pa-pa/HB-Sec-RHS-3/files/RHS_3.png

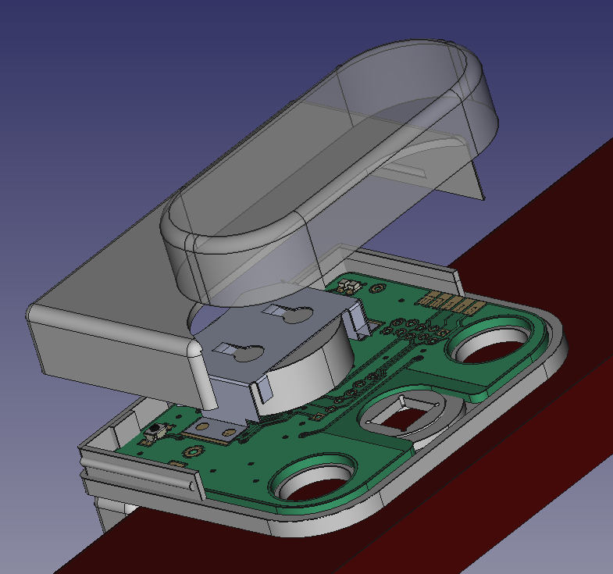
files/RHS_3.png
