pa-pa/HB-Sec-RHS-3/files/RHS_3_Front.png

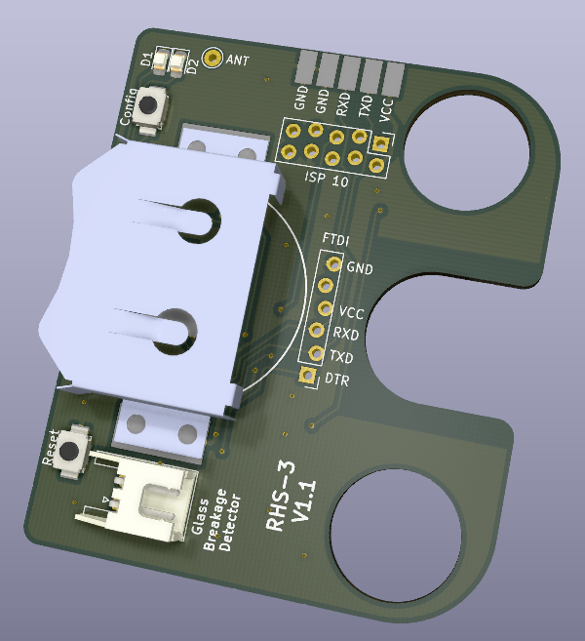
files/RHS_3_Front.png
