pa-pa/HB-Sec-RHS-3/files/RHS_3_small.png

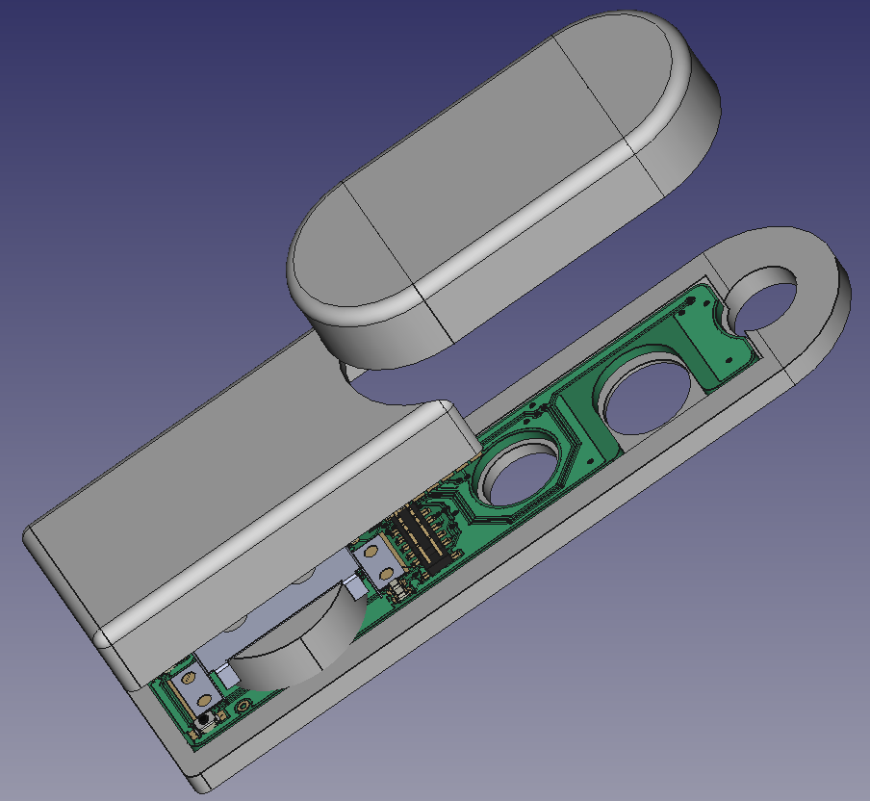
files/RHS_3_small.png
