pa-pa/HB-Sec-RHS-3/FreeCad/RHS_3_small.FCStd

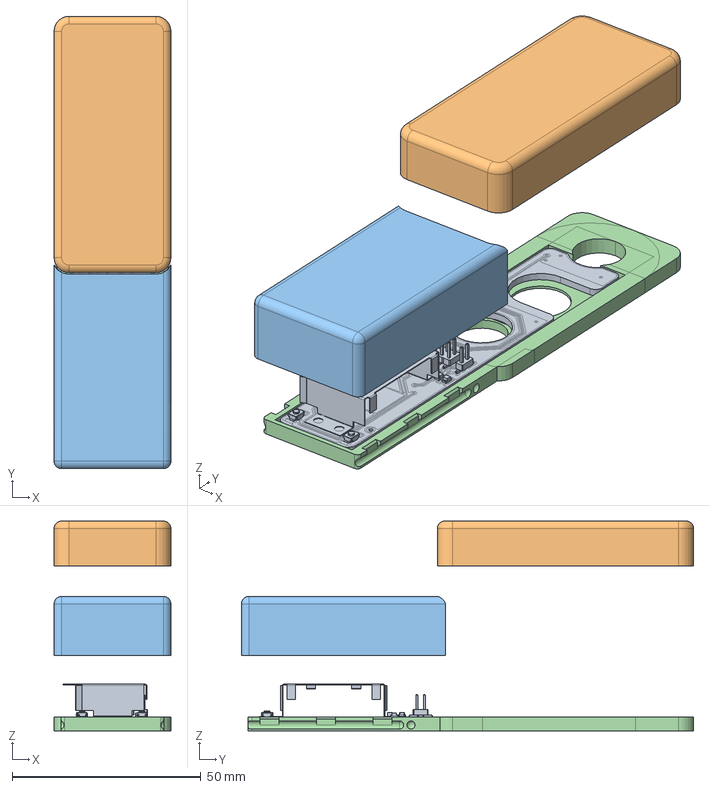
[picture p8: CAD file, 2020-06-21]
FreeCad/RHS_3_small.FCStd
31.0 x 120.0 x 55.7 mm
Platine
GriffEckig
DeckelEckig
BodenEckig
