pa-pa/HB-Sec-RHS-3/FreeCad/RHS_3.FCStd

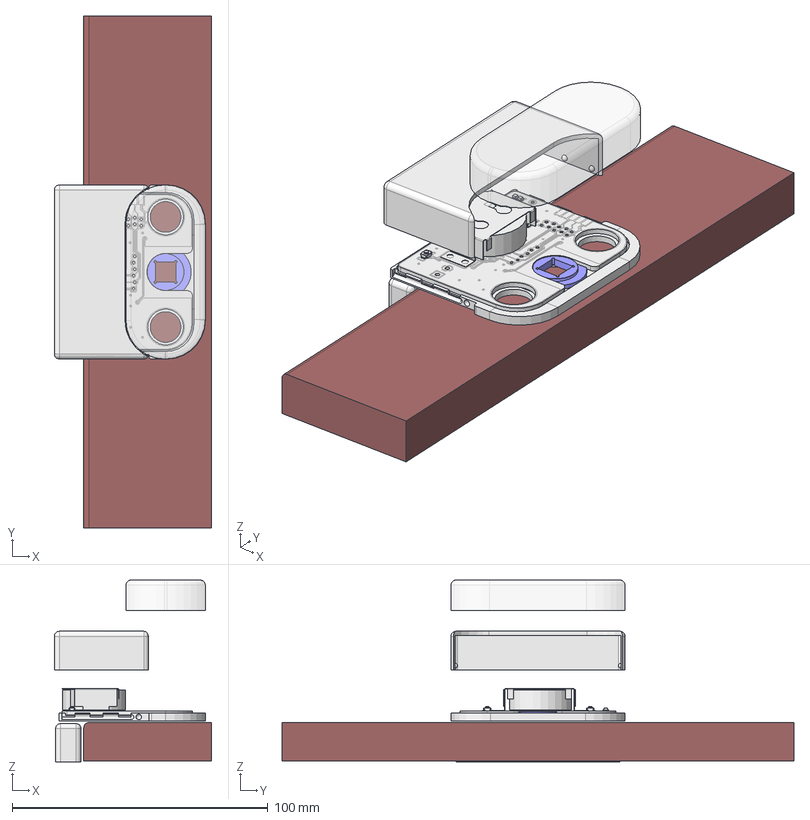
[picture p9: CAD file, 2020-05-25]
FreeCad/RHS_3.FCStd
61.5 x 200.0 x 71.1 mm
Unterteil
MagnetHalter
GriffR
CR2477
FensterRahmen
PlatineV_1_1
DeckelR
BodenR
