pa-pa/HB-Sec-RHS-3/FreeCad/DeckelRund_Small.stl

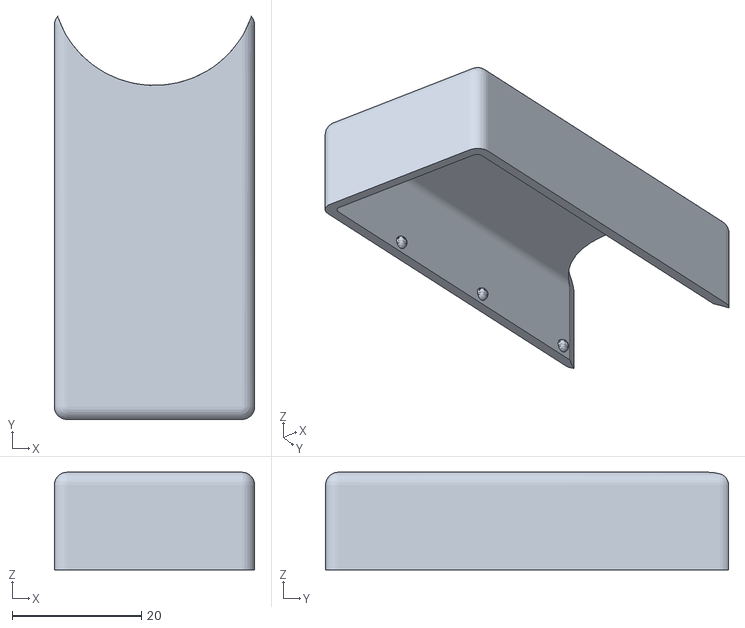
[picture p10: CAD file, 2020-04-24]
FreeCad/DeckelRund_Small.stl
31.0 x 62.3 x 15.1
