pa-pa/HB-Sec-RHS-3/FreeCad/BodenRund_Small.stl

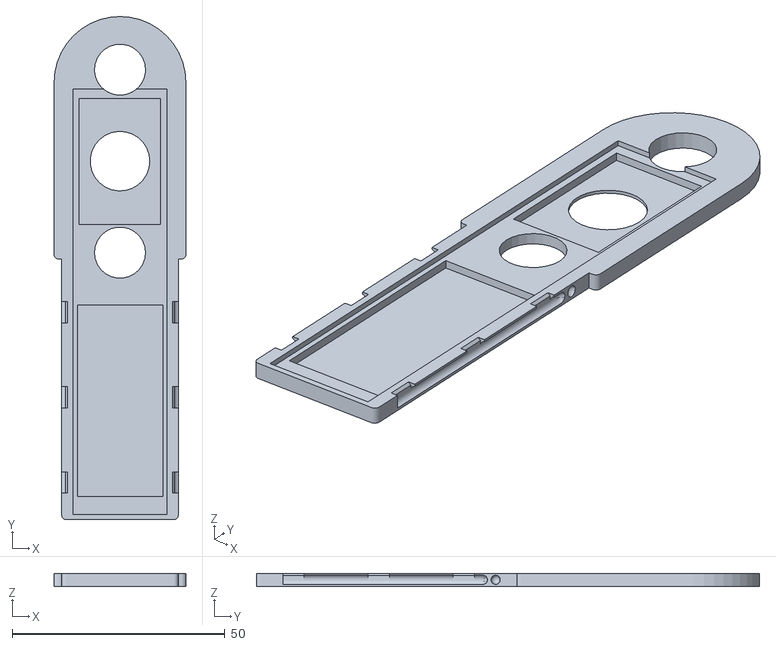
[picture p11: CAD file, 2020-04-24]
FreeCad/BodenRund_Small.stl
31.0 x 118.2 x 3.10
