pa-pa/HB-Sec-RHS-3/FreeCad/DeckelRund.stl

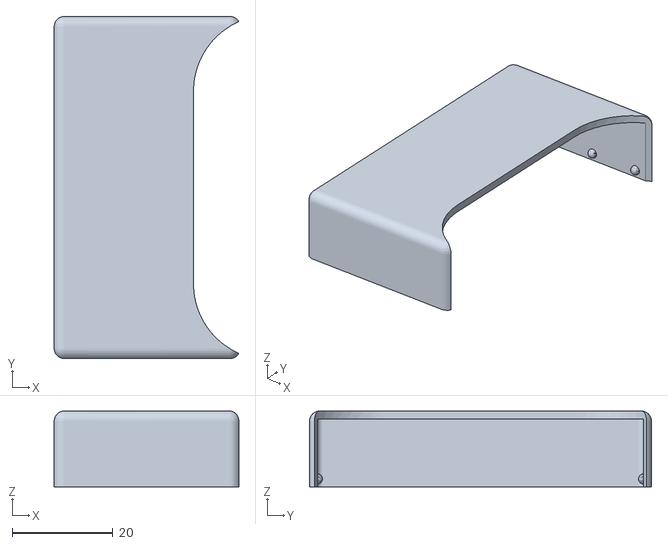
[picture p12: CAD file, 2020-04-22]
FreeCad/DeckelRund.stl
36.7 x 68.0 x 15.1
