pa-pa/HB-Sec-RHS-3/FreeCad/BodenRund.stl

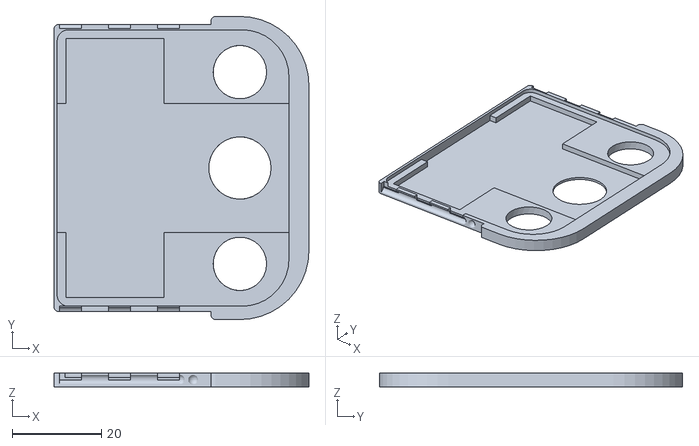
[picture p13: CAD file, 2020-04-22]
FreeCad/BodenRund.stl
57.2 x 68.0 x 3.10
