pa-pa/HB-Sec-RHS-3/FreeCad/MagnetHalter.stl

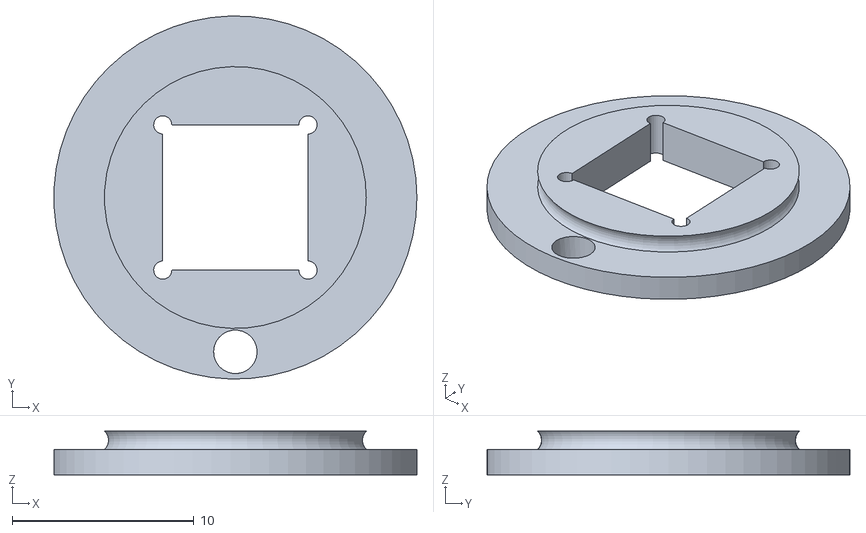
[picture p14: CAD file, 2020-04-21]
FreeCad/MagnetHalter.stl
20.0 x 20.0 x 2.40
