pa-pa/HB-Sec-RHS-3/files/RHS_3.pdf

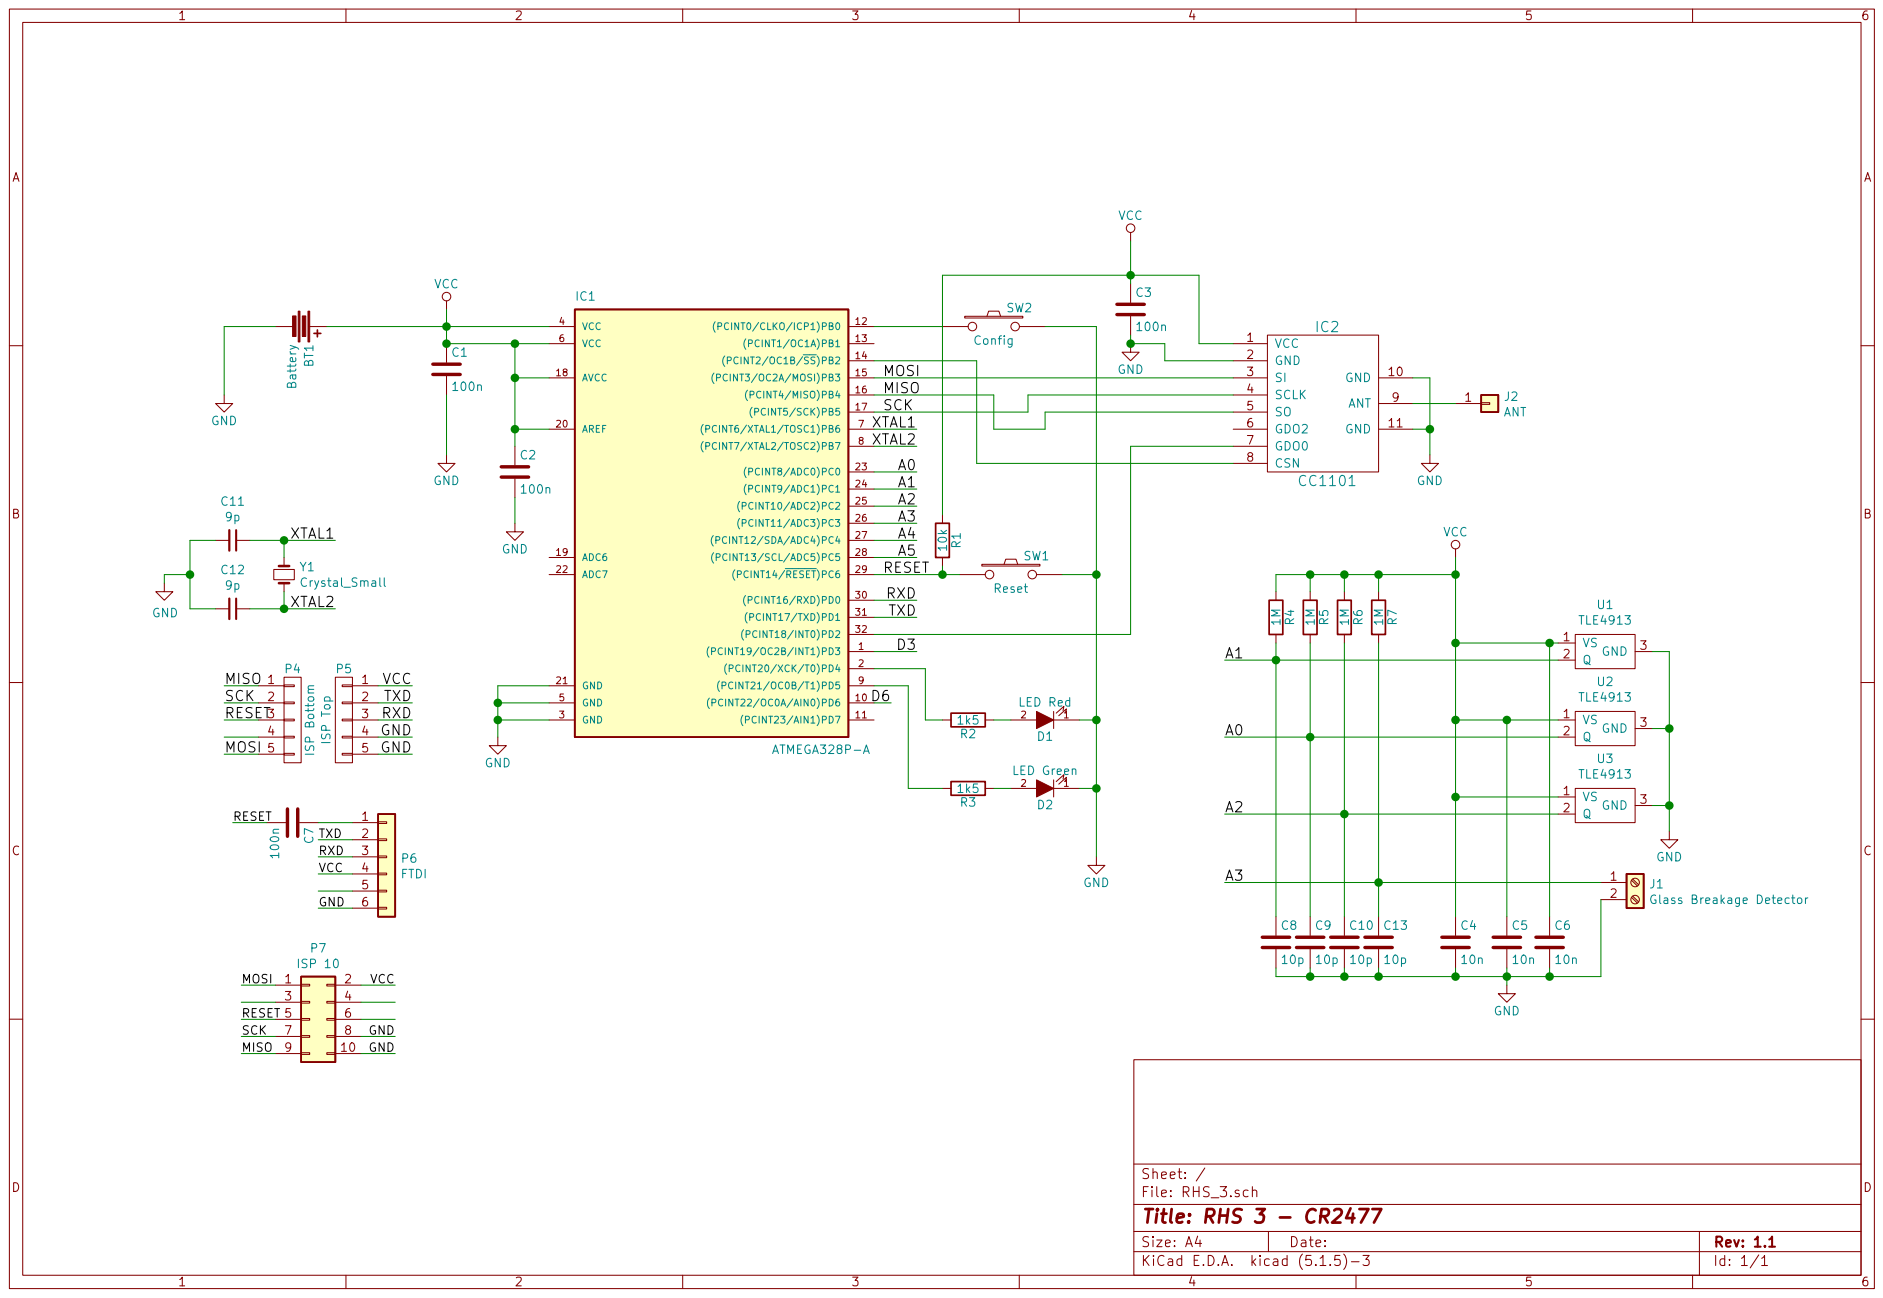
[picture p15: page 1]
