pa-pa/HB-Sec-RHS-3/RHS_3.kicad_pcb

## KiCad design RHS_3.kicad_pcb (2020-10-15)

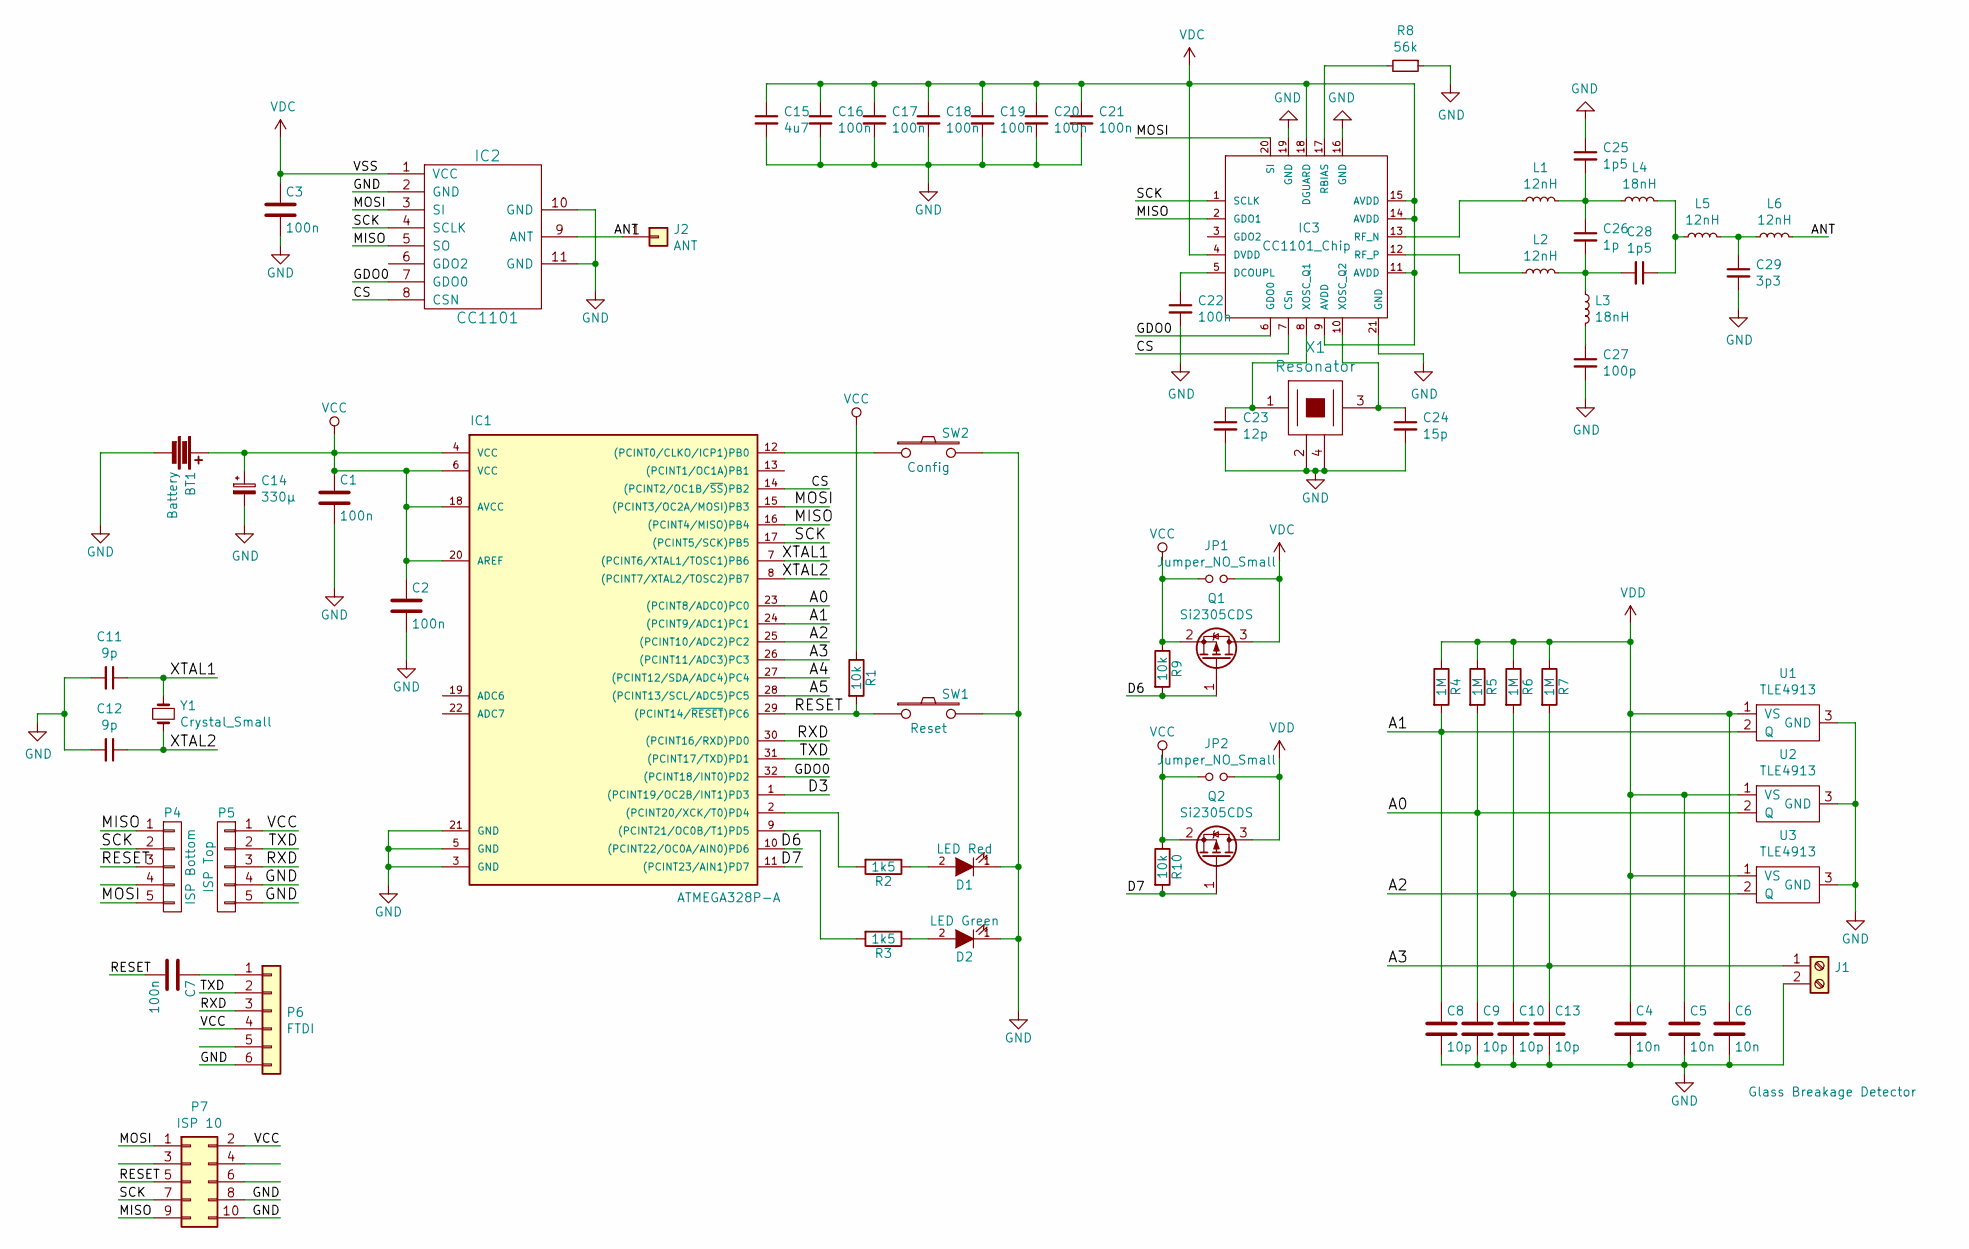
[picture p16: schematic RHS_3.sch, RHS 3 - CR2477]

Parts:
BT1: Battery; CR2477_Surface_Mount
C1, C2, C3, C7: 100n; C_0805_2012Metric_Pad1.15x1.40mm_HandSolder; LCSC Part # C49678
C4, C5, C6: 10n; C_0805_2012Metric_Pad1.15x1.40mm_HandSolder; LCSC Part # C1710
C8, C9, C10, C13: 10p; C_0805_2012Metric_Pad1.15x1.40mm_HandSolder; LCSC Part # C1785
C11, C12: 9p; C_0805_2012Metric_Pad1.15x1.40mm_HandSolder
C14: 330µ; CP_Elec_6.3x5.8
C15: 4u7; C_0402_1005Metric; LCSC Part # C23733
C16, C17, C18, C19, C20, C21, C22: 100n; C_0402_1005Metric; LCSC Part # C1525
C23: 12p; C_0402_1005Metric; LCSC Part # C1547
C24: 15p; C_0402_1005Metric; LCSC Part # C1548
C25, C28: 1p5; C_0402_1005Metric; LCSC Part # C1552
C26: 1p; C_0402_1005Metric; LCSC Part # C1550
C27: 100p; C_0402_1005Metric; LCSC Part # C1546
C29: 3p3; C_0402_1005Metric; LCSC Part # C1565
D1: LED Red; LED_0805_2012Metric_Pad1.15x1.40mm_HandSolder; LCSC Part # C84256
D2: LED Green; LED_0805_2012Metric_Pad1.15x1.40mm_HandSolder; LCSC Part # C2297
IC1: ATMEGA328P-A; TQFP-32_7x7mm_P0.8mm; LCSC Part # C14877
IC2: CC1101; CC1101_Module
IC3: CC1101_Chip; QFN-20-1EP_4x4mm_P0.5mm_EP2.5x2.5mm; LCSC Part # C29953
J1: Glass Breakage Detector; JST_XH_S2B-XH-A-1_1x02_P2.50mm_Horizontal
J2: ANT; Pin_D1.0mm_L10.0mm
JP1, JP2: Jumper_NO_Small; SolderJumper-2_P1.3mm_Bridged_Pad1.0x1.5mm
L1, L2, L5, L6: 12nH; L_0402_1005Metric; LCSC Part # C24563
L3, L4: 18nH; L_0402_1005Metric; LCSC Part # C24562
P4: ISP Bottom; ISP_Side
P5: ISP Top; ISP_Side
P6: FTDI; PinHeader_1x06_P2.54mm_Vertical
P7: ISP 10; PinHeader_2x05_P2.54mm_Vertical
Q1, Q2: Si2305CDS; SOT-23; LCSC Part # C37577
R1, R9, R10: 10k; R_0805_2012Metric_Pad1.15x1.40mm_HandSolder; LCSC Part # C17414
R2, R3: 1k5; R_0805_2012Metric_Pad1.15x1.40mm_HandSolder; LCSC Part # C4310
R4, R5, R6, R7: 1M; R_0805_2012Metric_Pad1.15x1.40mm_HandSolder; LCSC Part # C17514
R8: 56k; R_0402_1005Metric; LCSC Part # C25796
SW1: Reset; MicroSwitch_3x4
SW2: Config; MicroSwitch_3x4
U1, U2, U3: TLE4913; SOT-23; LCSC Part # C126654
X1: Resonator; Oscillator_SMD_EuroQuartz_XO32-4Pin_3.2x2.5mm; LCSC Part # C91747
Y1: Crystal_Small; Crystal_SMD_3215-2Pin_3.2x1.5mm

Connections:
/A0: C9.1, IC1.23 ((PCINT8/ADC0)PC0), R5.2, U2.2 (Q)
/A1: C8.1, IC1.24 ((PCINT9/ADC1)PC1), R4.2, U1.2 (Q)
/A2: C10.1, IC1.25 ((PCINT10/ADC2)PC2), R6.2, U3.2 (Q)
/A3: C13.1, IC1.26 ((PCINT11/ADC3)PC3), J1.1, R7.2
/A4: IC1.27 ((PCINT12/SDA/ADC4)PC4)
/A5: IC1.28 ((PCINT13/SCL/ADC5)PC5)
/ANT: IC2.9 (ANT), J2.1, L6.2
/CS: IC1.14 ((PCINT2/OC1B/~SS~)PB2), IC2.8 (CSN), IC3.7 (CSn)
/D3: IC1.1 ((PCINT19/OC2B/INT1)PD3)
/D6: IC1.10 ((PCINT22/OC0A/AIN0)PD6), Q1.1 (G), R9.2
/D7: IC1.11 ((PCINT23/AIN1)PD7), Q2.1 (G), R10.2
/GDO0: IC1.32 ((PCINT18/INT0)PD2), IC2.7 (GDO0), IC3.6 (GDO0)
/MISO: IC1.16 ((PCINT4/MISO)PB4), IC2.5 (SO), IC3.2 (GDO1), P4.1, P7.9
/MOSI: IC1.15 ((PCINT3/OC2A/MOSI)PB3), IC2.3 (SI), IC3.20 (SI), P4.5, P7.1
/RESET: C7.2, IC1.29 ((PCINT14/~RESET~)PC6), P4.3, P7.5, R1.2, SW1.1
/RXD: IC1.30 ((PCINT16/RXD)PD0), P5.3, P6.3
/SCK: IC1.17 ((PCINT5/SCK)PB5), IC2.4 (SCLK), IC3.1 (SCLK), P4.2, P7.7
/TXD: IC1.31 ((PCINT17/TXD)PD1), P5.2, P6.2
/XTAL1: C11.1, IC1.7 ((PCINT6/XTAL1/TOSC1)PB6), Y1.1
/XTAL2: C12.1, IC1.8 ((PCINT7/XTAL2/TOSC2)PB7), Y1.2
GND: BT1.2, C1.2, C2.2, C3.2, C4.2, C5.2, C6.2, C8.2, C9.2, C10.2, C11.2, C12.2, C13.2, C14.2, C15.2, C16.2, C17.2, C18.2, C19.2, C20.2, C21.2, C22.2, C23.2, C24.2, C25.1, C27.2, C29.2, D1.1 (K), D2.1 (K), IC1.3 (GND), IC1.5 (GND), IC1.21 (GND), IC2.2 (GND), IC2.10 (GND), IC2.11 (GND), IC3.16 (GND), IC3.19 (GND), IC3.21 (GND), J1.2, P5.4, P5.5, P6.6, P7.8, P7.10, R8.1, SW1.2, SW2.2, U1.3 (GND), U2.3 (GND), U3.3 (GND), X1.2, X1.4
unnamed: C7.1, P6.1
unnamed: C22.1, IC3.5 (DCOUPL)
unnamed: C23.1, IC3.8 (XOSC_Q1), X1.1
unnamed: C24.1, IC3.10 (XOSC_Q2), X1.3
unnamed: C25.2, C26.1, L1.2, L4.1
unnamed: C26.2, C28.2, L2.2, L3.1
unnamed: C27.1, L3.2
unnamed: C28.1, L4.2, L5.1
unnamed: C29.1, L5.2, L6.1
unnamed: D1.2 (A), R2.1
unnamed: D2.2 (A), R3.1
unnamed: IC1.2 ((PCINT20/XCK/T0)PD4), R2.2
unnamed: IC1.9 ((PCINT21/OC0B/T1)PD5), R3.2
unnamed: IC1.12 ((PCINT0/CLKO/ICP1)PB0), SW2.1
unnamed: IC3.12 (RF_P), L2.1
unnamed: IC3.13 (RF_N), L1.1
unnamed: IC3.17 (RBIAS), R8.2
VCC: BT1.1, C1.1, C2.1, C14.1, IC1.4 (VCC), IC1.6 (VCC), IC1.18 (AVCC), IC1.20 (AREF), JP1.1, JP2.1, P5.1, P6.4, P7.2, Q1.2 (S), Q2.2 (S), R1.1, R9.1, R10.1
VDC: C3.1, C15.1, C16.1, C17.1, C18.1, C19.1, C20.1, C21.1, IC2.1 (VCC), IC3.4 (DVDD), IC3.9 (AVDD), IC3.11 (AVDD), IC3.14 (AVDD), IC3.15 (AVDD), IC3.18 (DGUARD), JP1.2, Q1.3 (D)
VDD: C4.1, C5.1, C6.1, JP2.2, Q2.3 (D), R4.1, R5.1, R6.1, R7.1, U1.1 (VS), U2.1 (VS), U3.1 (VS)

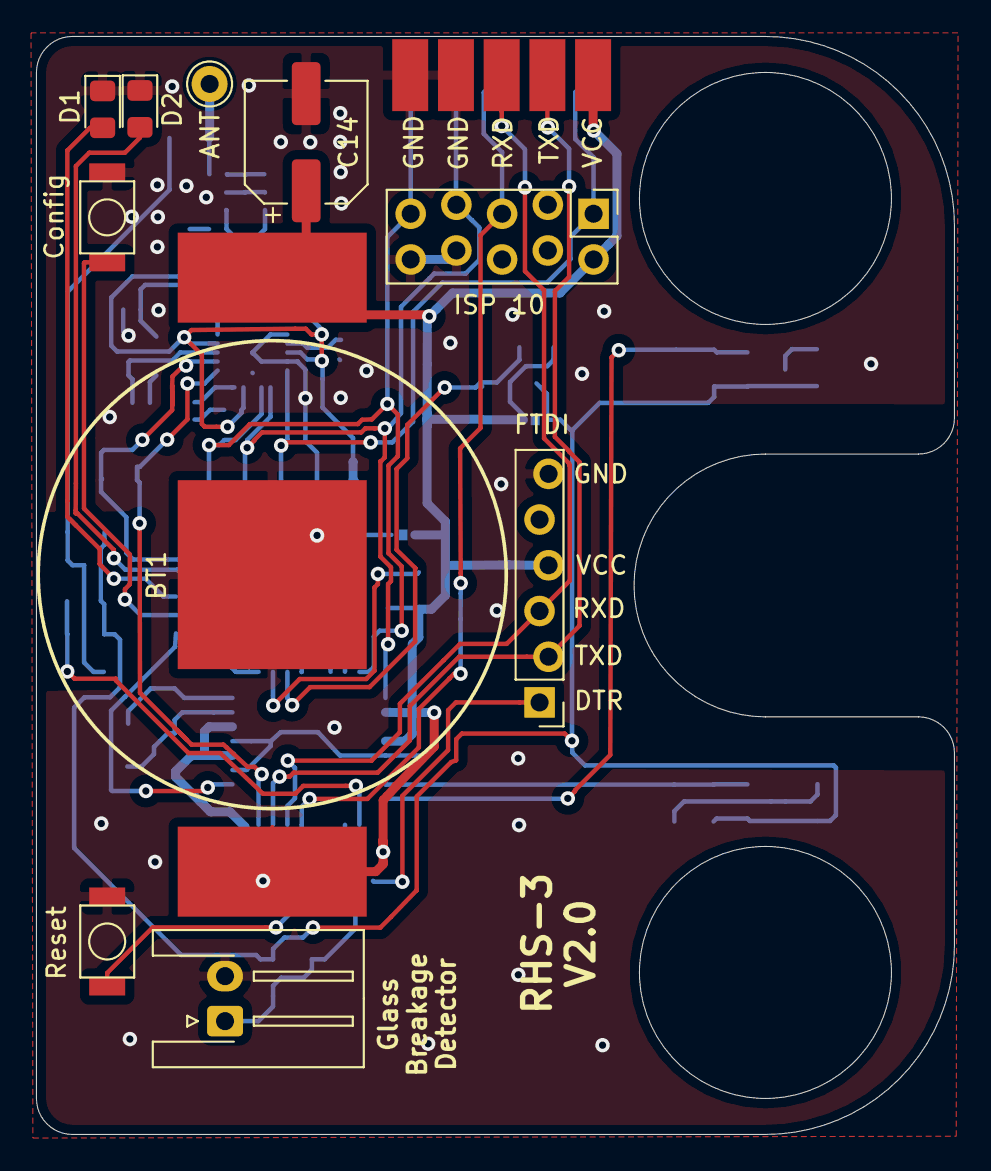
[picture p17: board RHS_3.kicad_pcb from above]

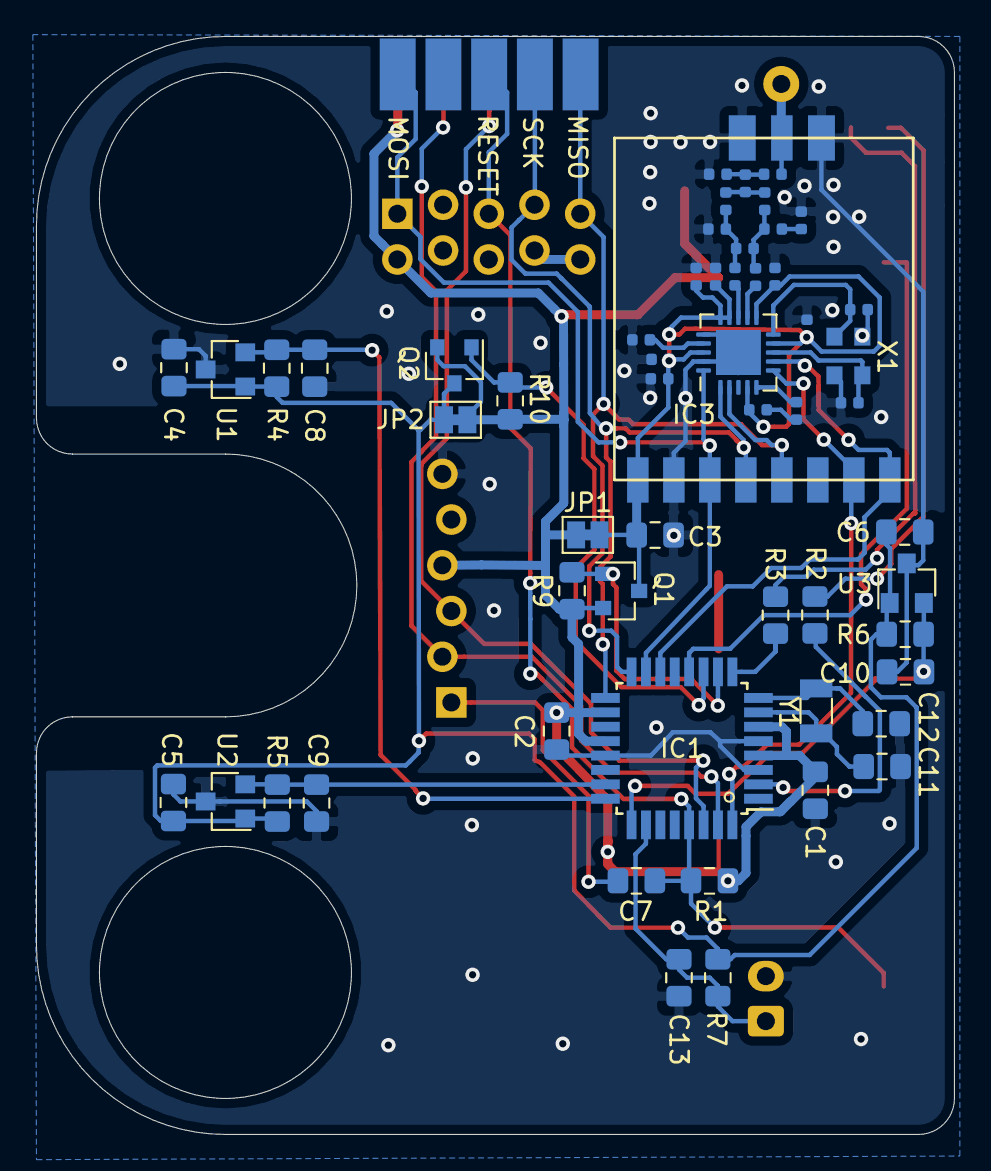
[picture p18: board RHS_3.kicad_pcb from below]

Board: 2 copper layers, 51.0 x 61.0 mm, 68 parts (57 on the bottom side), 38 nets.
