pa-pa/HB-Sec-RHS-3/(commit log)

2020-04-01 initial checkin
    [BOM_RHS_3.csv, BodenRund.stl, DeckelRund.stl, MagnetHalter.stl, RHS_3-2020-03-10-10-52-36.sch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]
2020-04-03 alternative pcb layout
    [RHS_3_Simple.kicad_pcb]
2020-04-06 V1.1 ready
    [BOM_RHS_3.csv, BOM_RHS_3.xlsx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]
2020-04-08 use parameter from sheet
    [RHS_3.FCStd]
2020-04-08 small version layouted
    [RHS_3_Simple-B_Cu.gbl, RHS_3_Simple-B_Mask.gbs, RHS_3_Simple-B_Paste.gbp, RHS_3_Simple-B_SilkS.gbo, RHS_3_Simple-Edge_Cuts.gm1, RHS_3_Simple-F_Cu.gtl, RHS_3_Simple-F_Mask.gts, RHS_3_Simple-F_Paste.gtp]
2020-04-09 small layout updates - finish for first prototyp
    [RHS_3_Simple-B_Cu.gbl, RHS_3_Simple-B_Mask.gbs, RHS_3_Simple-B_Paste.gbp, RHS_3_Simple-B_SilkS.gbo, RHS_3_Simple-Edge_Cuts.gm1, RHS_3_Simple-F_Cu.gtl, RHS_3_Simple-F_Mask.gts, RHS_3_Simple-F_Paste.gtp]
2020-04-09 case small
    [RHS_3_small.FCStd]
2020-04-20 some small updates
    [BodenRund.stl, DeckelRund.stl, MagnetHalter.stl, RHS_3.FCStd]
2020-04-21 TLE pads resized
    [MagnetHalter.stl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]
2020-04-22 TLE-Pads resized again
    [RHS_3-B_Cu.gbl, RHS_3-B_Mask.gbs, RHS_3-B_Paste.gbp, RHS_3-B_SilkS.gbo, RHS_3-Edge_Cuts.gm1, RHS_3-F_Cu.gtl, RHS_3-F_Mask.gts, RHS_3-F_Paste.gtp]
2020-04-22 init sensor before channel
2020-04-22 case updates
    [BodenRund.stl, BodenRund_Small.stl, DeckelRund.stl, DeckelRund_Small.stl, RHS_3.FCStd, RHS_3_small.FCStd]
2020-04-24 production files added
    [BOM_RHS_3.xlsx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]
2020-05-25 fix missing GND
    [RHS_3-B_Cu.gbl, RHS_3-B_Mask.gbs, RHS_3-B_Paste.gbp, RHS_3-B_SilkS.gbo, RHS_3-Edge_Cuts.gm1, RHS_3-F_Cu.gtl, RHS_3-F_Mask.gts, RHS_3-F_Paste.gtp]
2020-06-08 fix missing GND areas
    [RHS_3-B_Cu.gbl, RHS_3-B_Mask.gbs, RHS_3-B_Paste.gbp, RHS_3-B_SilkS.gbo, RHS_3-Edge_Cuts.gm1, RHS_3-F_Cu.gtl, RHS_3-F_Mask.gts, RHS_3-F_Paste.gtp]
2020-06-19 new case variant
    [RHS_3_small.FCStd]
2020-06-19 use 1,6mm pcb height
    [RHS_3_small.FCStd]
2020-06-21 space for magnet holder fixed
    [RHS_3_small.FCStd]
2020-10-07 optional CC1101 direct use
    [RHS_3.kicad_pcb, RHS_3.sch]
2020-10-08 Jumper added to prepare switch of VCC for CC1101 und Sensors
    [RHS_3.kicad_pcb, RHS_3.sch]
2020-10-08 CC1101 footprint fixed
    [RHS_3.kicad_pcb, RHS_3.sch]
2020-10-09 layout changed
    [RHS_3.kicad_pcb, RHS_3.sch]
2020-10-09 part numbers added
    [RHS_3.sch]
2020-10-11 switches for TLEs & CC1101 added
    [RHS_3.kicad_pcb, RHS_3.sch]
2020-10-12 layout updates
    [RHS_3.kicad_pcb]
2020-10-15 gerber and production files updated
    [BOM_RHS_3.csv, BOM_RHS_3.xlsx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]
2020-10-15 fix 100p
    [BOM_RHS_3.csv, BOM_RHS_3.xlsx, RHS_3.kicad_pcb, RHS_3.sch]
2021-02-12 make path compatible with Arduino IDE
2021-02-12 power pin
